remaks/nrl-sht1x/docs/T-RH Sensor Hub Panel Layout.dxf

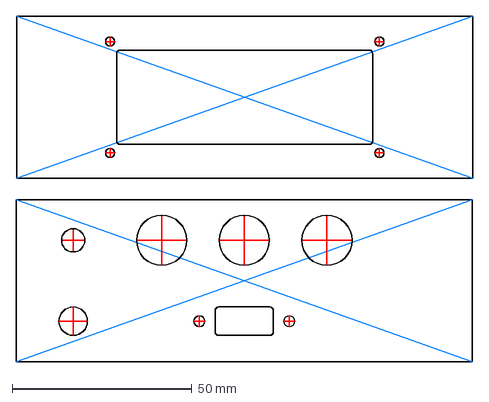
[picture p1: CAD file, 2012-10-31]
docs/T-RH Sensor Hub Panel Layout.dxf
127.1 x 96.1 mm
