remaks/nrl-sht1x/(list of files, cad)

Other CAD files:
docs/T-RH Sensor Hub Panel Layout.dwg
