remaks/nrl-sht1x/docs/TODO.txt

******************
* NRL-SHT1x TODO *
******************

- Add LCD Unit display option
- Add serial command to change LCD temperature unit
- Add EEPROM storage of LCD temperature unit
